drewcassidy/OSHWatch/hardware/Power Board.brd

## EAGLE design hardware/Power Board.brd (2016-09-18)

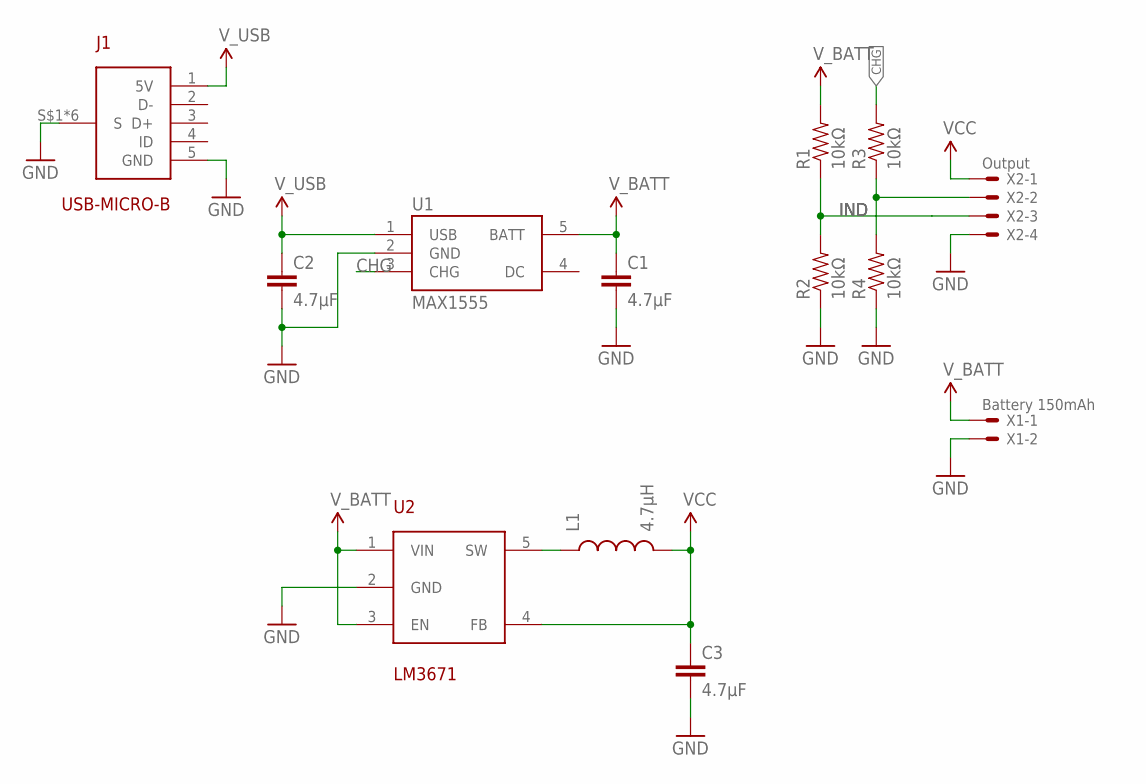
[picture p1: schematic Power Board.sch]

Parts:
C1, C2, C3: 4.7µF; 0805
J1: USB-MICRO-B; UB-MC5BR3
L1: 4.7µH; 0805
R1, R2, R3, R4: 10kΩ; 0805
U1: MAX1555; SOT23-5
U2: LM3671; SOT23-5
X1: Battery 150mAh; SM02B-SRSS-TB
X2: Output; SM04B-SRSS-TB

Connections:
CHG: R3.2, U1.3 (CHG)
CHG_2: R3.1, R4.2, X2.2
GND: C1.2, C2.2, C3.2, J1.5 (GND), J1.S$1 (S), J1.S$2 (S), J1.S$3 (S), J1.S$4 (S), J1.S$5 (S), J1.S$6 (S), R2.1, R4.1, U1.2 (GND), U2.2 (GND), X1.2, X2.4
IND: R1.1, R2.2, X2.3
unnamed: L1.1, U2.5 (SW)
VCC: C3.1, L1.2, U2.4 (FB), X2.1
V_BATT: C1.1, R1.2, U1.5 (BATT), U2.1 (VIN), U2.3 (EN), X1.1
V_USB: C2.1, J1.1 (5V), U1.1 (USB)

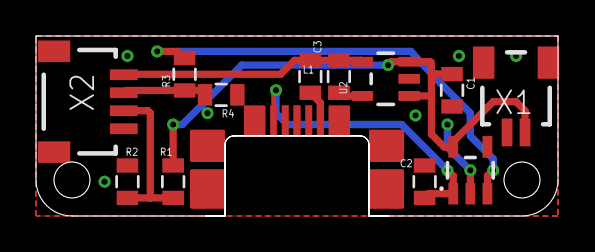
[picture p2: board Power Board.brd from above]

Board: 2 copper layers, 29.0 x 10.0 mm, 13 parts (0 on the bottom side), 8 nets.
