drewcassidy/OSHWatch/hardware/Processor Board.brd

## EAGLE design hardware/Processor Board.brd (2016-09-18)

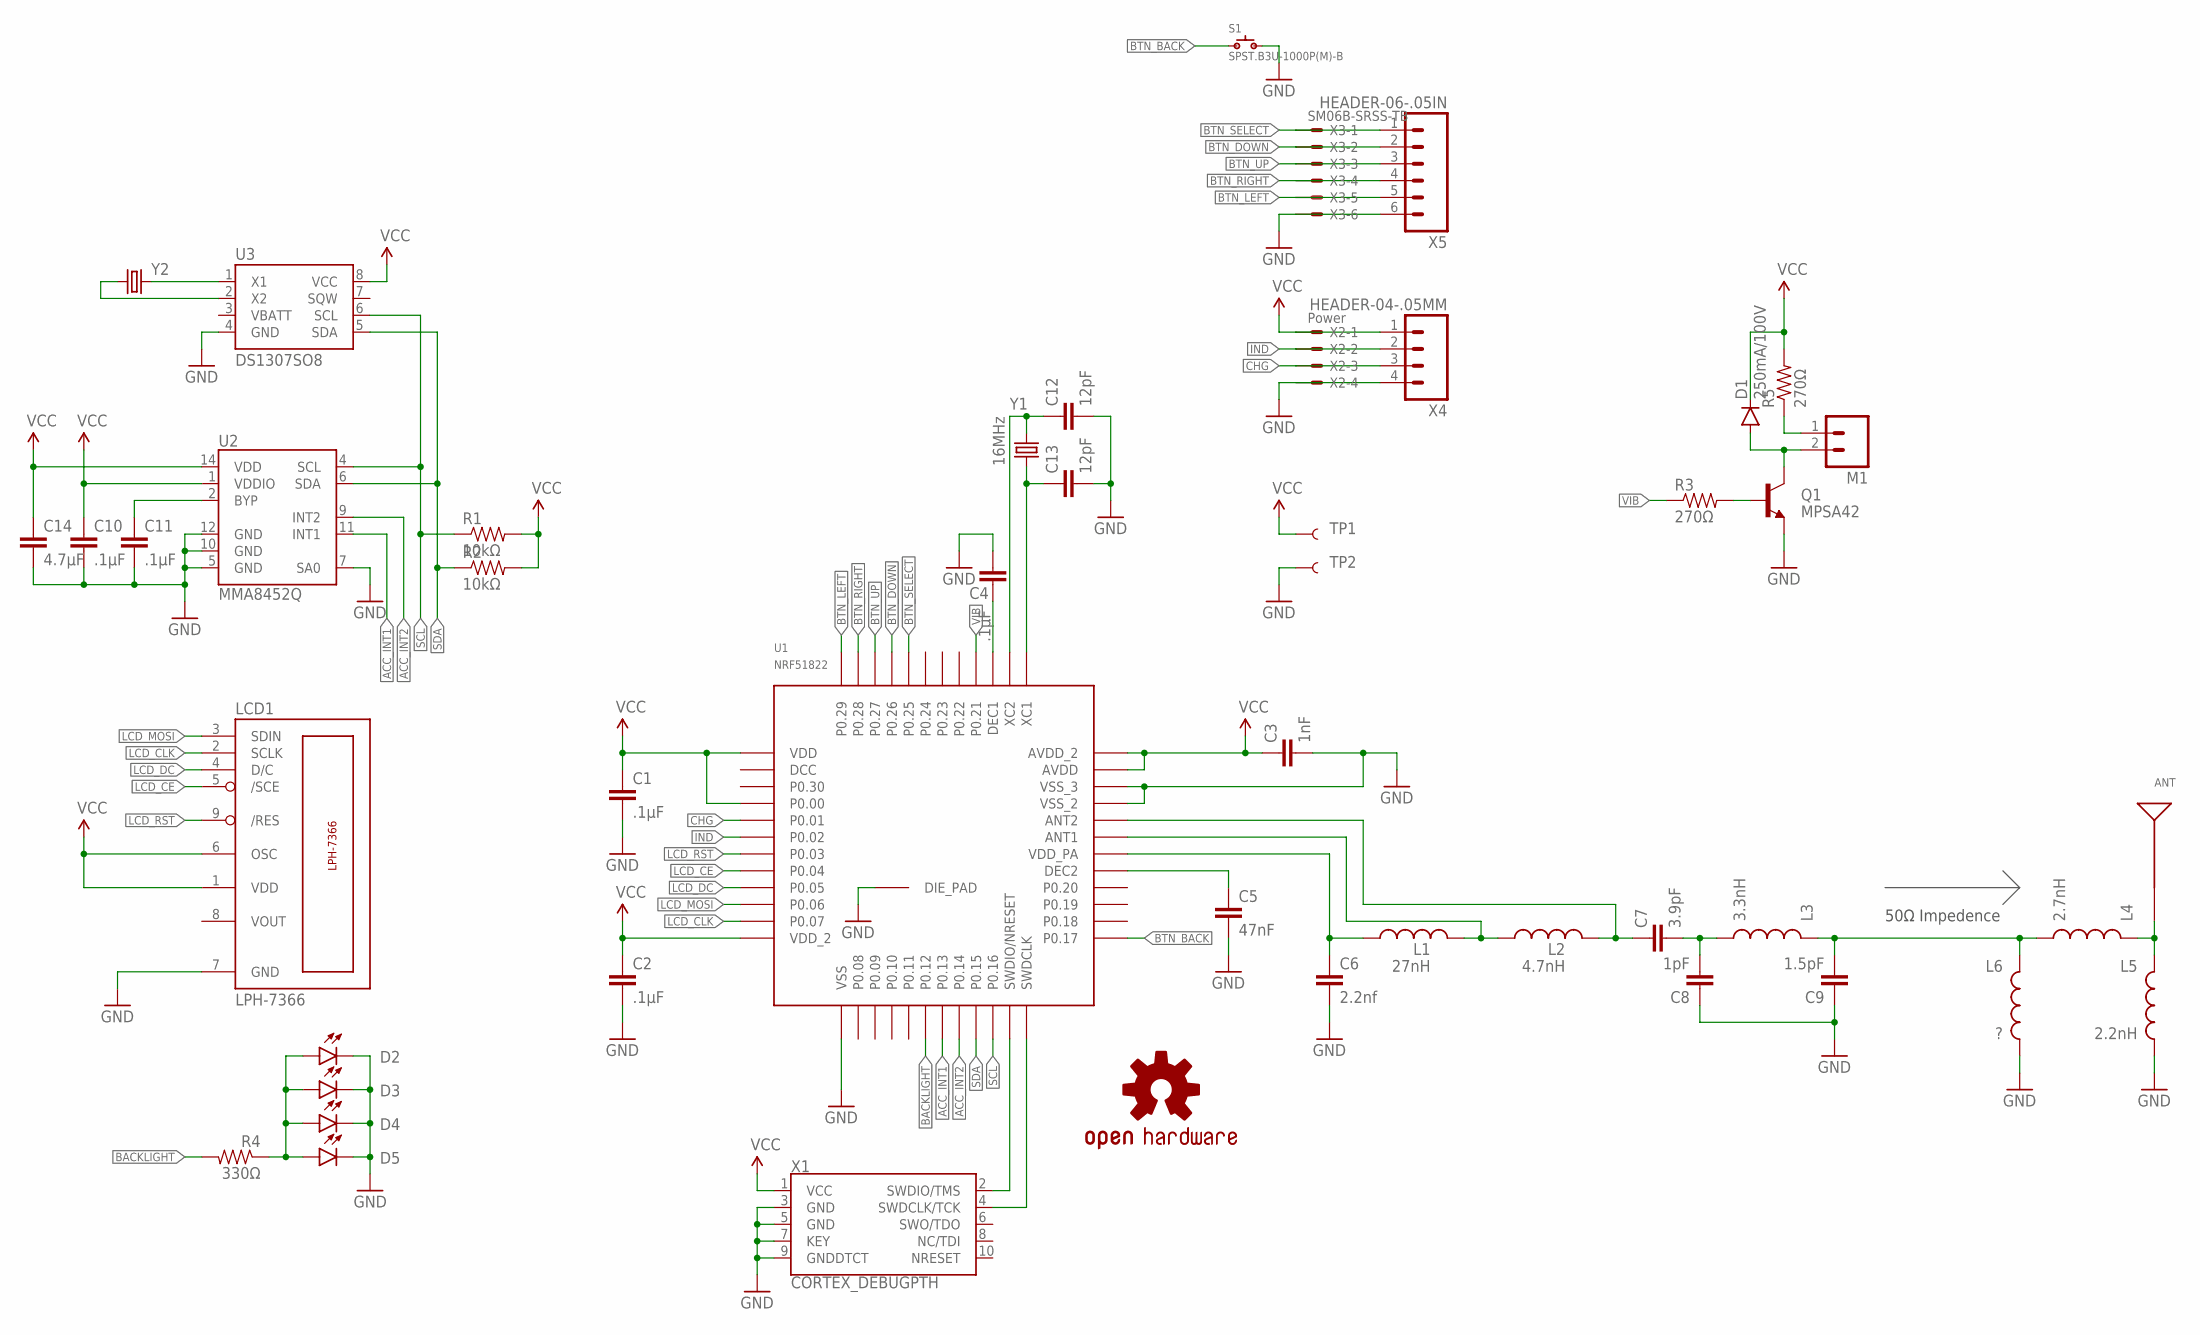
[picture p3: schematic Processor Board.sch]

Parts:
ANT: ANTENNA_CHIP2450AT43B100; AT43B
C1, C2, C4, C10, C11: .1µF; 0805
C3: 1nF; 0805
C5: 47nF; 0805
C6: 2.2nf; 0805
C7: 3.9pF; 0805
C8: 1pF; 0805
C9: 1.5pF; 0805
C12, C13: 12pF; 0805
C14: 4.7µF; 0805
D1: 250mA/100V; SOD-323
D2, D3, D4, D5: LED1206; LED-1206
L1: 27nH; 0805
L2: 4.7nH; 0805
L3: 3.3nH; 0805
L4: 2.7nH; 0805
L5: 2.2nH; 0805
L6: ?; 0805
LCD1: LPH-7366
LOGO1: OSHW-LOGOL-COPPER; OSHW-LOGO-L_COPPER
M1: M021X02_NO_SILK; 1X02_NO_SILK
Q1: MPSA42; SOT23-3
R1, R2: 10kΩ; 0805
R3, R5: 270Ω; 0805
R4: 330Ω; 0805
S1: SPST.B3U-1000P(M)-B; B3U-1000P(M)-B
TP1, TP2: TEST-POINT3; PAD.03X.03
U1: NRF51822; QFN48
U2: MMA8452Q; QFN-16_0.5MM
U3: DS1307SO8; SO08
X1: CORTEX_DEBUGPTH; 2X5-PTH-1.27MM
X2: Power; SM04B-SRSS-TB
X3: SM06B-SRSS-TB
X4: HEADER-04-.05MM; HEADER-04-.05IN
X5: HEADER-06-.05IN
Y1: 16MHz; CRYSTAL-SMD-5X3
Y2: CRYSTAL32-SMD-MELF; CRYSTAL-32KHZ-SMD-MELF

Connections:
ACC_INT1: U1.19 (P0.13), U2.11 (INT1)
ACC_INT2: U1.20 (P0.14), U2.9 (INT2)
ANT: ANT.ANT, L4.1, L5.1
ANT1: L1.1, L2.2, U1.31 (ANT1)
ANT2: C7.1, L2.1, U1.32 (ANT2)
BACKLIGHT: R4.2, U1.18 (P0.12)
BTN_BACK: S1.1, U1.25 (P0.17)
BTN_DOWN: U1.45 (P0.26), X3.2, X5.2
BTN_LEFT: U1.48 (P0.29), X3.5, X5.5
BTN_RIGHT: U1.47 (P0.28), X3.4, X5.4
BTN_SELECT: U1.44 (P0.25), X3.1, X5.1
BTN_UP: U1.46 (P0.27), X3.3, X5.3
CHG: U1.5 (P0.01), X2.3, X4.3
F_1: C7.2, C8.2, L3.2
F_2: C9.2, L3.1, L4.2, L6.1
GND: C1.2, C2.2, C3.2, C4.1, C5.2, C6.2, C8.1, C9.1, C10.2, C11.2, C12.1, C13.1, C14.2, D2.C, D3.C, D4.C, D5.C, L5.2, L6.2, LCD1.7 (GND), Q1.2 (E), S1.2, TP2.P$1, U1.13 (VSS), U1.33 (VSS_2), U1.34 (VSS_3), U1.GND (DIE_PAD), U2.5 (GND), U2.7 (SA0), U2.10 (GND), U2.12 (GND), U3.4 (GND), X1.3 (GND), X1.5 (GND), X1.7 (KEY), X1.9 (GNDDTCT), X2.4, X3.6, X4.4, X5.6
IND: U1.6 (P0.02), X2.2, X4.2
LCD_CE: LCD1.5 (/SCE), U1.8 (P0.04)
LCD_CLK: LCD1.2 (SCLK), U1.11 (P0.07)
LCD_DC: LCD1.4 (D/C), U1.9 (P0.05)
LCD_MOSI: LCD1.3 (SDIN), U1.10 (P0.06)
LCD_RST: LCD1.9 (/RES), U1.7 (P0.03)
unnamed: U1.24 (SWDCLK), X1.4 (SWDCLK/TCK)
unnamed: C4.2, U1.39 (DEC1)
unnamed: U1.23 (SWDIO/NRESET), X1.2 (SWDIO/TMS)
unnamed: C5.1, U1.29 (DEC2)
unnamed: C11.1, U2.2 (BYP)
unnamed: Q1.1 (B), R3.2
unnamed: C12.2, U1.38 (XC2), Y1.3 (2)
unnamed: C13.2, U1.37 (XC1), Y1.1
unnamed: U3.1 (X1), Y2.X2 (2)
unnamed: D1.A, M1.2, Q1.3 (C)
unnamed: M1.1, R5.1
unnamed: U3.2 (X2), Y2.X1 (1)
unnamed: D2.A, D3.A, D4.A, D5.A, R4.1
SCL: R1.1, U1.22 (P0.16), U2.4 (SCL), U3.6 (SCL)
SDA: R2.1, U1.21 (P0.15), U2.6 (SDA), U3.5 (SDA)
VCC: C1.1, C2.1, C3.1, C10.1, C14.1, D1.C, LCD1.1 (VDD), LCD1.6 (OSC), R1.2, R2.2, R5.2, TP1.P$1, U1.1 (VDD), U1.4 (P0.00), U1.12 (VDD_2), U1.35 (AVDD), U1.36 (AVDD_2), U2.1 (VDDIO), U2.14 (VDD), U3.8 (VCC), X1.1 (VCC), X2.1, X4.1
VDD_PA: C6.1, L1.2, U1.30 (VDD_PA)
VIB: R3.1, U1.40 (P0.21)

Notes on the sheet:
50Ω Impedence

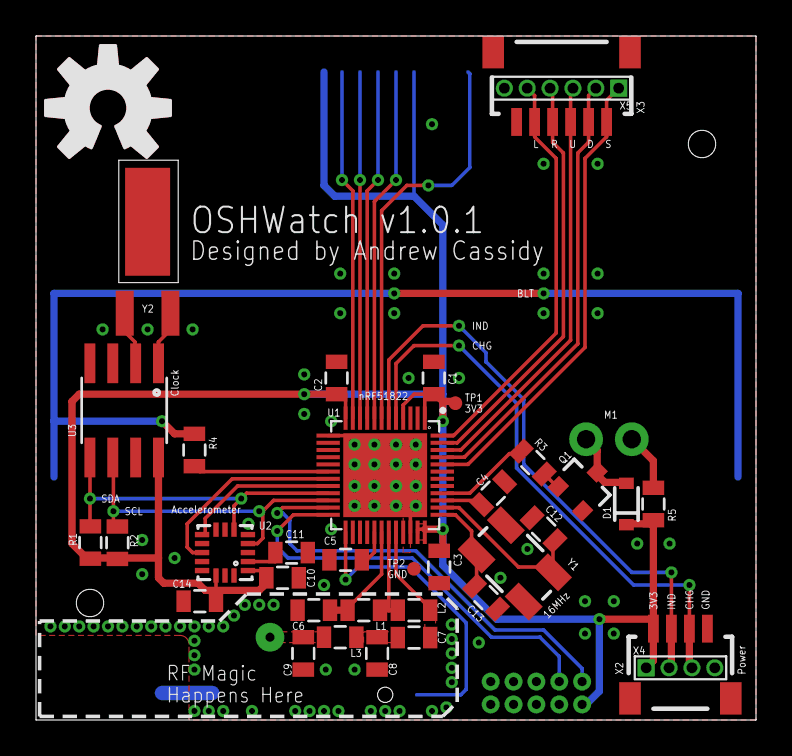
[picture p4: board Processor Board.brd from above]

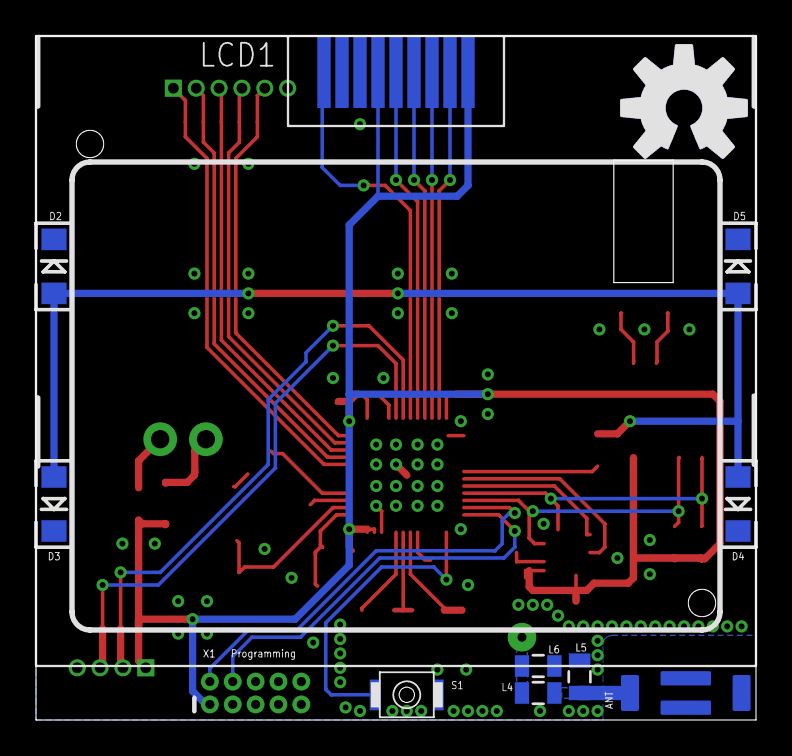
[picture p5: board Processor Board.brd from below]

Board: 2 copper layers, 40.0 x 38.0 mm, 51 parts (13 on the bottom side), 40 nets.

Other parts of the board:
LOGO2: OSHW-LOGOL-COPPER; OSHW-LOGO-L_COPPER
U$1, U$2: OSHW-LOGO-L
