drewcassidy/OSHWatch/hardware/Switch Board.brd

## EAGLE design hardware/Switch Board.brd (2016-04-25)

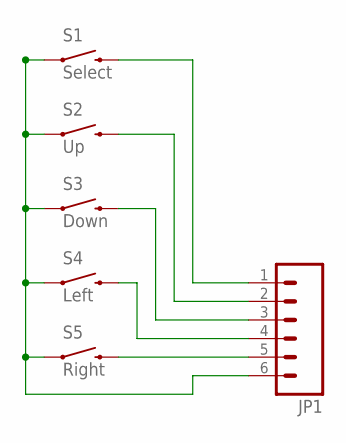
[picture p6: schematic Switch Board.sch]

Parts:
JP1: M06SMD-1MM; 1X06-1MM
S1: Select; TACTILE-SWITCH-SMD
S2: Up; TACTILE-SWITCH-SMD
S3: Down; TACTILE-SWITCH-SMD
S4: Left; TACTILE-SWITCH-SMD
S5: Right; TACTILE-SWITCH-SMD

Connections:
GND: JP1.6, S1.1, S2.1, S3.1, S4.1, S5.1
unnamed: JP1.5, S5.3 (2)
unnamed: JP1.4, S4.3 (2)
unnamed: JP1.3, S3.3 (2)
unnamed: JP1.2, S2.3 (2)
unnamed: JP1.1, S1.3 (2)

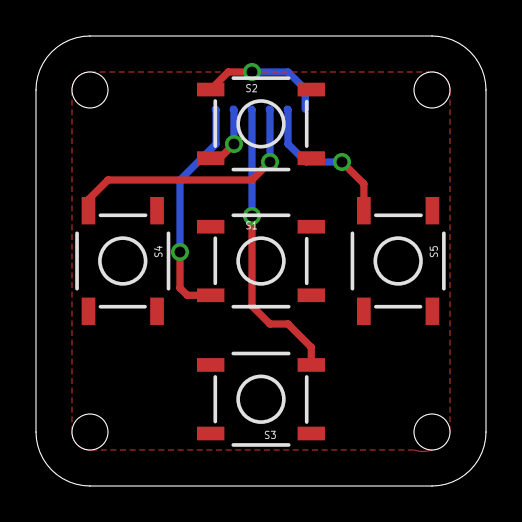
[picture p7: board Switch Board.brd from above]

Board: 2 copper layers, 25.0 x 25.0 mm, 6 parts (1 on the bottom side), 6 nets.
