drewcassidy/OSHWatch/src/bitmaps.cpp

#include "bitmaps.h"

const uint8_t Digit0[55] = {
    0x00, 0x00, 0x14, 0x11,
    0x3F, 0xFF, 0xC0, 0x7F, 0xFF, 0xE0, 0x70, 0x01,
    0xE0, 0x70, 0x01, 0xE0, 0x70, 0x01, 0xE0, 0x70,
    0x01, 0xE0, 0x70, 0x01, 0xE0, 0x70, 0x01, 0xE0,
    0x70, 0x01, 0xE0, 0x70, 0x01, 0xE0, 0x70, 0x01,
    0xE0, 0x70, 0x01, 0xE0, 0x70, 0x01, 0xE0, 0x70,
    0x01, 0xE0, 0x7F, 0xFF, 0xE0, 0x7F, 0xFF, 0xC0,
    0x3F, 0xFF, 0x80
};

const uint8_t Digit1[55] = {
    0x00, 0x00, 0x14, 0x11,
    0x00, 0x70, 0x0F, 0x07, 0xF0, 0x0F, 0x07, 0xF0,
    0x0F, 0x07, 0xF0, 0x0F, 0x00, 0x70, 0x0F, 0x00,
    0x70, 0x0F, 0x00, 0x70, 0x0F, 0x00, 0x70, 0x0F,
    0x00, 0x70, 0x0F, 0x00, 0x70, 0x0F, 0x00, 0x70,
    0x0F, 0x00, 0x70, 0x0F, 0x00, 0x70, 0x0F, 0x00,
    0x70, 0x0F, 0x1F, 0xFF, 0xCF, 0x1F, 0xFF, 0xCF,
    0x1F, 0xFF, 0xCF
};

const uint8_t Digit2[55] = {
    0x00, 0x00, 0x14, 0x11,
    0x1F, 0xFF, 0xC0, 0x3F, 0xFF, 0xE0, 0x38, 0x01,
    0xE0, 0x38, 0x01, 0xE0, 0x38, 0x01, 0xE0, 0x00,
    0x03, 0xC0, 0x00, 0x0F, 0x80, 0x00, 0x1F, 0x00,
    0x00, 0x7C, 0x00, 0x00, 0xF8, 0x00, 0x03, 0xE0,
    0x00, 0x0F, 0xC0, 0x00, 0x1F, 0x01, 0xE0, 0x7C,
    0x01, 0xE0, 0x7F, 0xFF, 0xE0, 0x7F, 0xFF, 0xC0,
    0x7F, 0xFF, 0x80
};

const uint8_t Digit3[55] = {
    0x00, 0x00, 0x14, 0x11,
    0x3F, 0xFF, 0x80, 0x7F, 0xFF, 0xC0, 0x78, 0x03,
    0xC0, 0x78, 0x01, 0xC0, 0x00, 0x01, 0xC0, 0x00,
    0x01, 0xC0, 0x00, 0x03, 0xC0, 0x01, 0xFF, 0x80,
    0x01, 0xFF, 0xC0, 0x00, 0x01, 0xE0, 0x00, 0x01,
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
};

const uint8_t IconYoutube[36] = {
    0x00, 0x00, 0x10, 0x10,
    0x3F, 0xFC, 0x7F, 0xFE, 0xFF, 0xFF, 0xFF, 0xFF,
    0xE0, 0x07, 0xC3, 0x03, 0xC3, 0x83, 0xC3, 0xC3,
    0xC3, 0xC3, 0xC3, 0x83, 0xC3, 0x03, 0xE0, 0x07,
    0xFF, 0xFF, 0xFF, 0xFF, 0x7F, 0xFE, 0x3F, 0xFC
};
