drewcassidy/OSHWatch/src/pins.h

#ifndef	OSHWATCH_PINS_H
#define	OSHWATCH_PINS_H

#define	CHG 		(p1)
#define IND			(p2)
#define LCD_RST		(p3)
#define LCD_CE		(p4)
#define LCD_DC		(p5)
#define LCD_MOSI 	(p6)
#define LCD_CLK		(p7)
#define BACKLIGHT   (p12)
#define ACC_INT1    (p13)
#define ACC_INT2    (p14)
#define SDA         (p15)
#define SCL         (p16)
#define BTN_BACK    (p17)
#define VIB         (p21)
#define BTN_SELECT  (p25)
#define BTN_DOWN    (p26)
#define BTN_UP      (p27)
#define BTN_RIGHT   (p28)
#define BTN_LEFT    (p29)

#endif //OSHWATCH_PINS_H
