drewcassidy/OSHWatch/src/bitmaps.h

#ifndef BITMAPS_H
#define BITMAPS_H

#include <stdint.h>

extern const uint8_t Digit0[55];
extern const uint8_t Digit1[55];
extern const uint8_t Digit2[55];
extern const uint8_t Digit3[55];
extern const uint8_t Digit4[55];
extern const uint8_t Digit5[55];
extern const uint8_t Digit6[55];
extern const uint8_t Digit7[55];
extern const uint8_t Digit8[55];
extern const uint8_t Digit9[55];
extern const uint8_t IconAlarm[36];
extern const uint8_t IconCalendar[36];
extern const uint8_t IconEmail[36];
extern const uint8_t IconFacebook[36];
extern const uint8_t IconGithub[36];
extern const uint8_t IconLinkedin[36];
extern const uint8_t IconMessage[36];
extern const uint8_t IconOther[36];
extern const uint8_t IconPhone[36];
extern const uint8_t IconSlack[36];
extern const uint8_t IconSnapchat[36];
extern const uint8_t IconTodo[36];
extern const uint8_t IconTumblr[36];
extern const uint8_t IconTwitter[36];
extern const uint8_t IconYoutube[36];

#endif
