drewcassidy/OSHWatch/(commit log)

2016-04-25 Add Power and Button boards
    [Power Board.brd, Power Board.sch, Processor Board.sch, Switch Board.brd, Switch Board.sch]
2016-09-18 Add bitmaps and python code to turn them into valid C++
    This python is an abomination 🙃🐍
    [Power Board.brd, Power Board.sch, Processor Board.brd, Processor Board.sch]
2016-12-16 migrate to mbedOS 5
    • delete yotta config files
    • move software to its own directory
    • reformat files
    • change includes to work with mbed OS 5
2016-12-17 Correct error in pins.h
    [pins.h]
2016-12-17 Fix for boards without the LFCLK
2016-12-17 expand pins.h to include buttons, I2C, and misc outputs
2016-12-17 adjust contrast to better match my test board
2016-12-29 Migrate to Platformio
    • move source files to src/
    • add Travis.yml
    • add cmake files
2016-12-29 Migrate to Platformio (for real)
    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
2017-02-01 Complete demo watchface • change '1' digit bitmap • finish watchface drawing program • add constants for day and month names
